barrettbrody06/stm32-quadcopter-fc/hardware/fc-board/power.kicad_sch

## KiCad design hardware/fc-board/power.kicad_sch (2026-08-24, an earlier design)

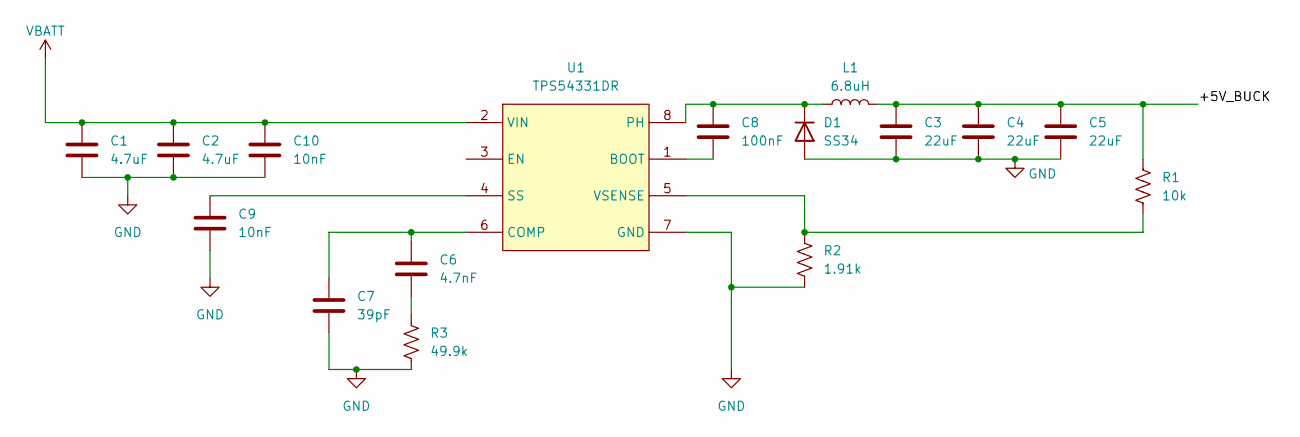
[picture p1: schematic power.kicad_sch]

Parts:
C1, C2: 4.7uF
C3, C4, C5: 22uF
C6: 4.7nF
C7: 39pF
C8: 100nF
C9, C10: 10nF
D1: SS34
L1: 6.8uH
R1: 10k; R_0603_1608Metric
R2: 1.91k; R_0603_1608Metric
R3: 49.9k; R_0603_1608Metric
U1: TPS54331DR; SOIC-8_L5.0-W4.0-P1.27-LS6.0-BL; MPN TPS54331DR; LCSC Part C9865

Connections:
+5V_BUCK: C3.1, C4.1, C5.1, L1.2, R1.1
GND: C1.2, C2.2, C3.2, C4.2, C5.2, C7.2, C9.2, C10.2, D1.2 (A), R2.2, R3.2, U1.7 (GND)
unnamed: C6.1, C7.1, U1.6 (COMP)
unnamed: C6.2, R3.1
unnamed: C8.1, D1.1 (K), L1.1, U1.8 (PH)
unnamed: C8.2, U1.1 (BOOT)
unnamed: C9.1, U1.4 (SS)
unnamed: R1.2, R2.1, U1.5 (VSENSE)
VBATT: C1.1, C2.1, C10.1, U1.2 (VIN)
