barrettbrody06/stm32-quadcopter-fc/(commit log)

2026-08-07 Add KiCad project for STM32 flight controller board
    [fc-board.kicad_pcb, fc-board.kicad_sch]
2026-08-07 Add hierarchical sheet structure: power, MCU, IMU, motors, radio
    [fc-board.kicad_sch, imu.kicad_sch, mcu.kicad_sch, motors.kicad_sch, power.kicad_sch, radio.kicad_sch]
2026-08-08 Updated parts.md with power components
2026-08-08 Added Buck inductor to parts.md
2026-08-08 Completed parts.md
    [fc-board.kicad_pcb, imu.kicad_sch, mcu.kicad_sch, motors.kicad_sch, radio.kicad_sch]
2026-08-08 Power Sheet: TPS54331 buck converter section
2026-08-10 Power sheet: AP2112K 3.3V LDO section
    [fc-board.kicad_pcb, power.kicad_sch]
2026-08-10 Power sheet: battery input, TVS, Schottky OR
    [power.kicad_sch]
2026-08-10 Power sheet: USB
    [power.kicad_sch]
2026-08-10 Power sheet complete: PWR_FLAGs, no-connect on EN, ERC clean
    [fc-board.kicad_sch, power.kicad_sch]
2026-08-10 Added stm32_pinout_ref
    [stm32_pinout_ref.csv]
2026-08-19 MCU sheet: F411 core, HSE, SWD, boot select; ERC fixes
    [fc-board.kicad_sch, mcu.kicad_sch, power.kicad_sch]
2026-08-19 IMU sheet: ICM-42605 on SPI1
    [fc-board.kicad_sch, imu.kicad_sch]
2026-08-19 IMU, Motors, Radio sheets; schematic complete
    [fc-board.kicad_sch, motors.kicad_sch, radio.kicad_sch]
2026-08-24 Adopt main as canonical; rescue BOM from master; correct README
    Replaces the inaccurate README that lived on the orphaned master branch. Adds MIT LICENSE, the rescued bill of materials, and PCB layout docs. Reconciles .gitignore against main's original so KiCad lock files, temp backups and Python artifacts stay excluded, and stops the VS Code .history directory being committed as a gitlink.
2026-08-24 Remove external footprint dependency; make VBATT sheet-local
    R1-R7 repointed from SparkFun-Resistor to Resistor_SMD:R_0603_1608Metric, the stock KiCad footprint already used by R20-R26 -- identical 0603 land pattern, so a clean checkout no longer needs a library it does not have. VBATT demoted from hierarchical to local label on the power sheet and its orphaned root-sheet pin removed: the net is consumed entirely on the power sheet by the sense divider, so exporting it created a sheet pin with no consumer and the project's only ERC violation. ERC now clean.
    [fc-board.kicad_sch, power.kicad_sch]
2026-08-24 Remove external footprint dependency; make VBATT sheet-local; ERC clean
    R1-R7 repointed from SparkFun-Resistor to Resistor_SMD:R_0603_1608Metric, the stock KiCad footprint already used by R20-R26 -- identical 0603 land pattern, so a clean checkout no longer needs a library it does not have. VBATT demoted from hierarchical to local label on the power sheet and its orphaned root-sheet pin removed: the net is consumed entirely on the power sheet by the sense divider, so exporting it created a sheet pin with no consumer and the project's only ERC violation. ERC now measures 0. README updated to match.
2026-08-25 Replace prototype BOM with the real one; link datasheets instead of vendoring
    bom/bom.md was the Nucleo-F411RE/GY-91/FS-iA6B shopping list from the abandoned breadboard concept -- the same phantom project the old README described -- and directly contradicted the current README. Replaced with docs/parts.md, the actual fc-board BOM with LCSC part numbers and design maths. Vendor datasheet PDFs replaced by docs/datasheets/README.md linking manufacturer sources, so the repo does not redistribute third-party documents under its MIT license. status.md rewritten (it still specified VCAP1 as 2.2uF, which the design corrects to 4.7uF) and layout-plan.md's resolved VBATT question removed.
